felixheld/AXIOM-photonSDI-hw/README.md

AXIOM-photonSDI-hw
===

SDI interface board for the apertus° AXIOM beta camera

* dual high-speed AXIOM connector 
* 2x 6G SDI output on HD-BNC connector
* 1x 6G SDI input on HD-BNC connector
* 1x sync input on HD-BNC connector

Designed with the nightly builds of KiCad version 5. To have all symbols and footprints that are used in the design, you currently need to use the KiCad footprint and symbol repositories on my GitHub account.
