felixheld/AXIOM-photonSDI-hw/AXIOM-photonSDI-hw.pdf

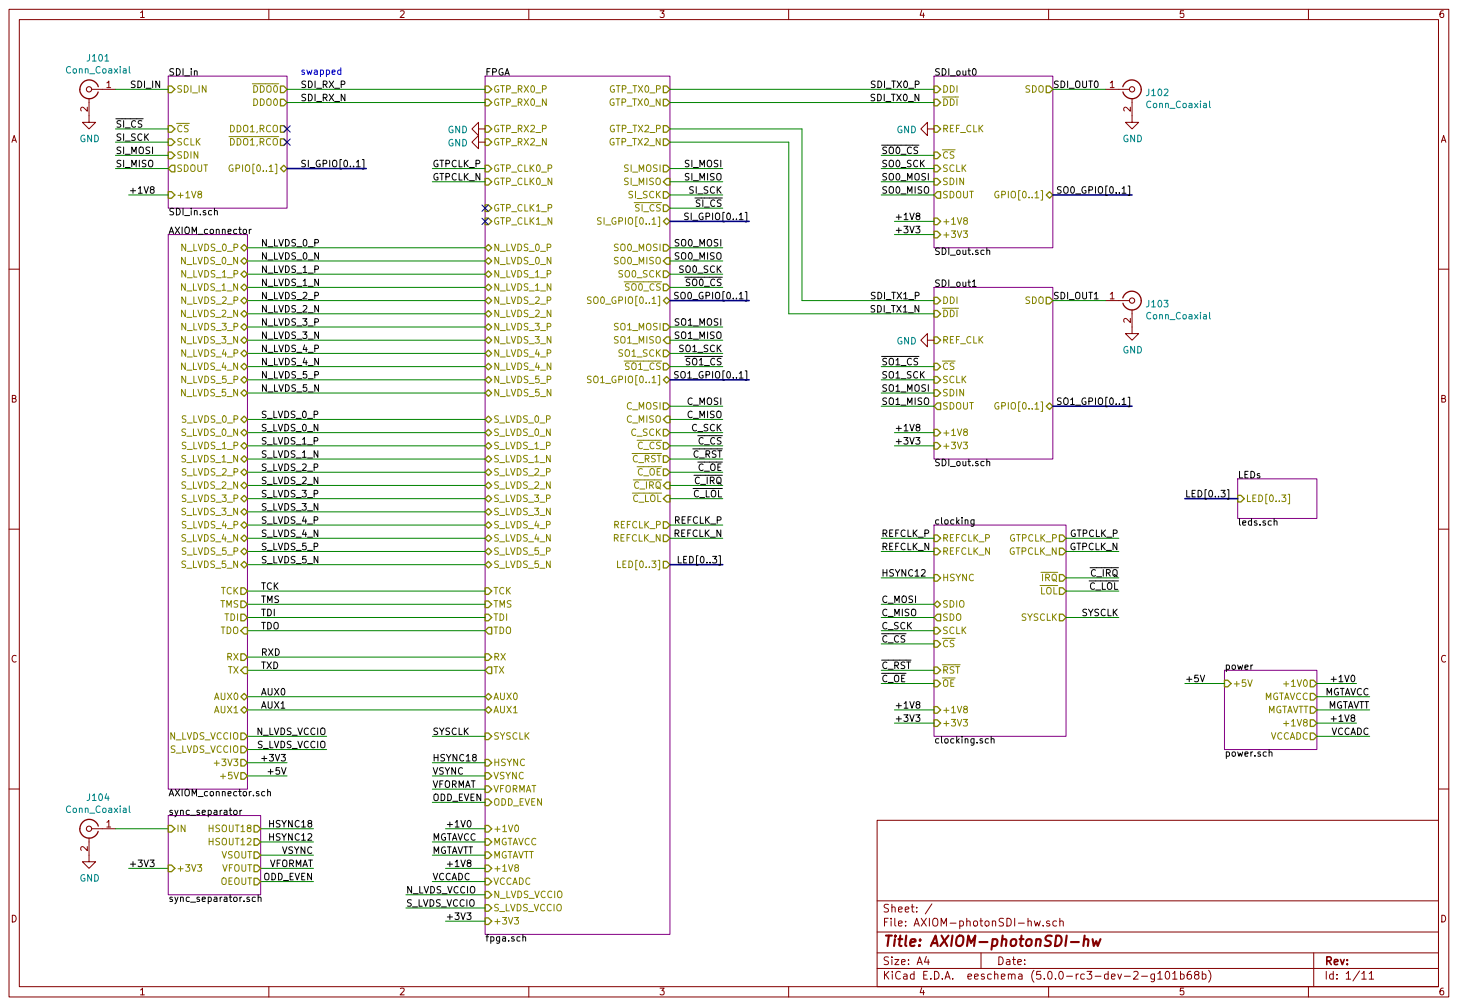
[picture p1: page 1]

SO1_MOSI SO1_MISO | SDI_TX1_N

N_LVDS_3_P N_LVDS_3_N | | SO1_CS

N_LVDS_4_P N_LVDS_4_N | | SO1_SCK

File: AXIOM-photonSDI-hw.sch Sheet: /
Id: 1/11 Title: AXIOM-photonSDI-hw

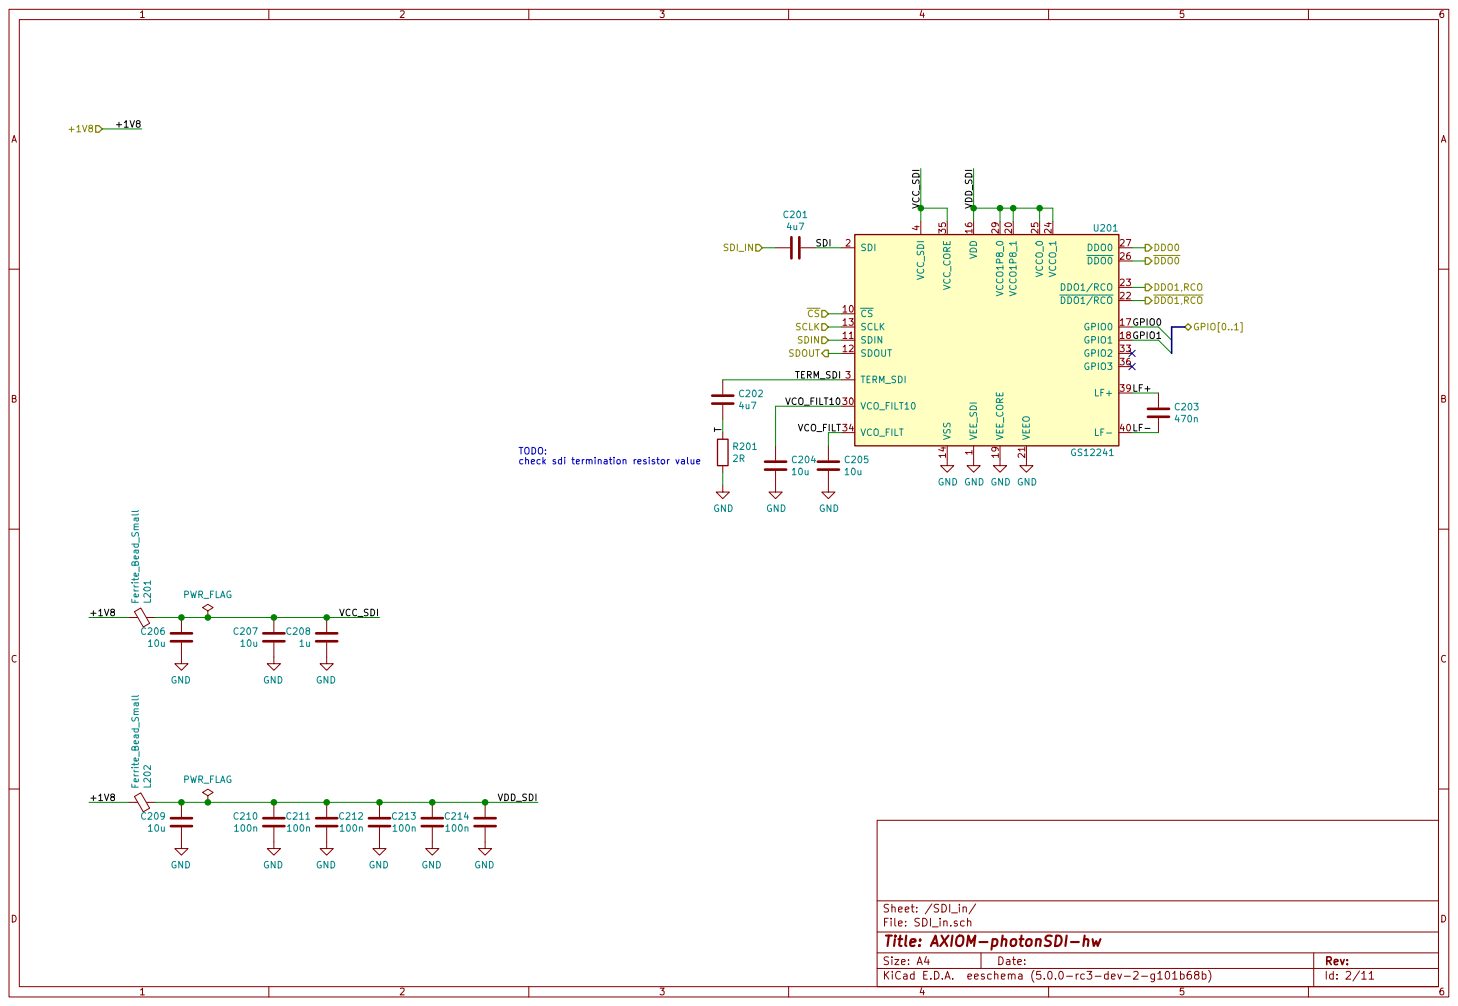
[picture p2: page 2]

470n GND GND GND GND

File: SDI_in.sch
Id: 2/11 Title: AXIOM-photonSDI-hw

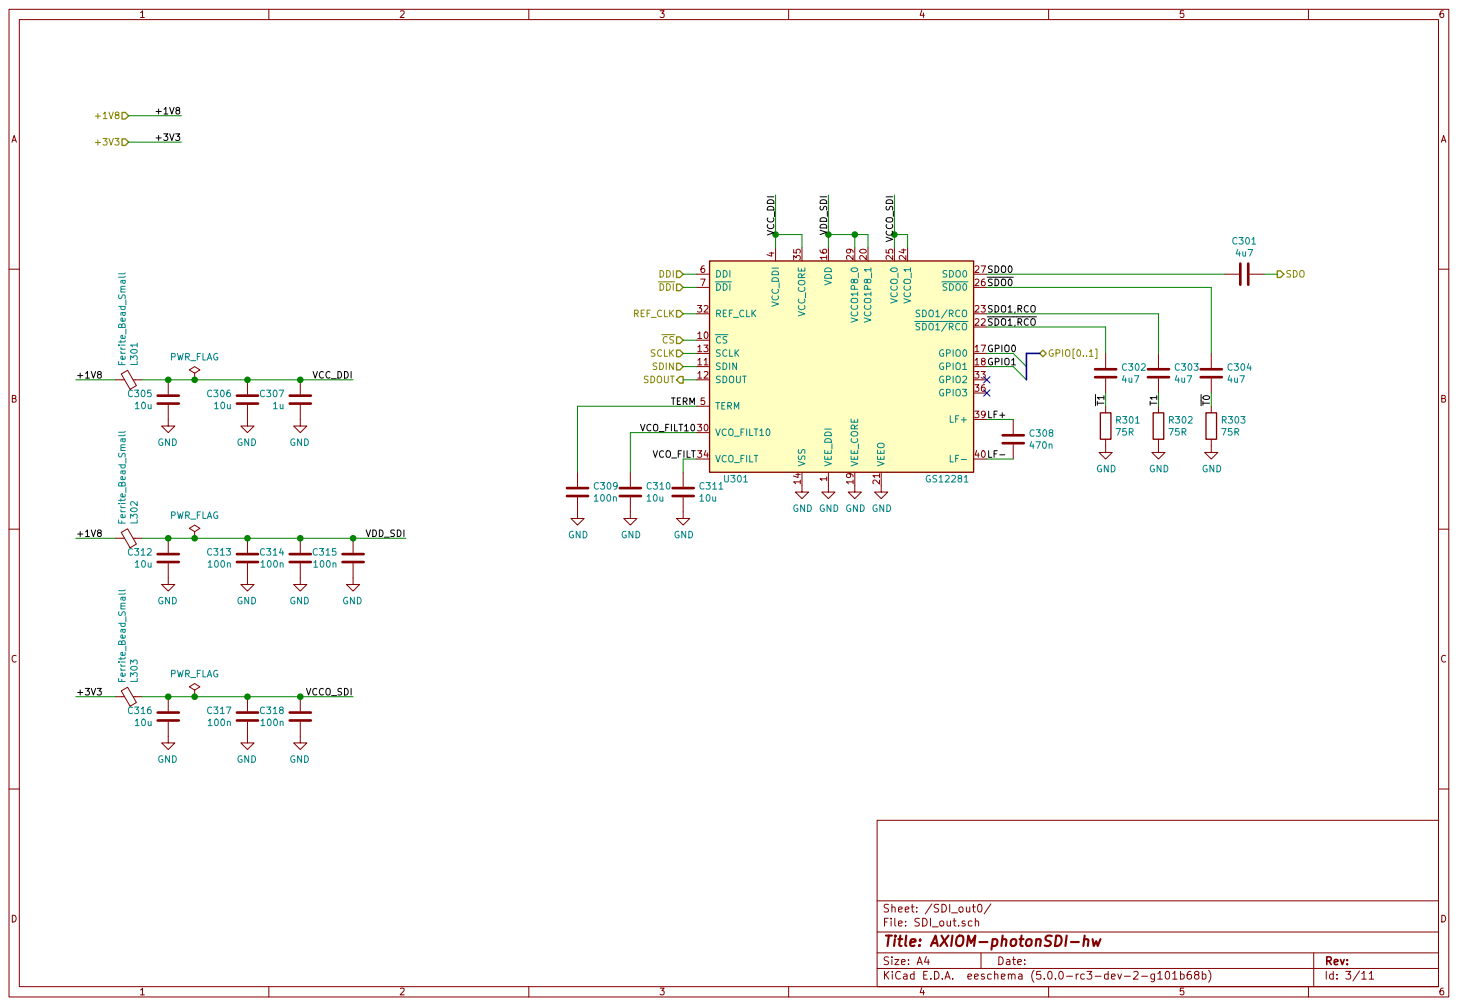
[picture p3: page 3]

470n GND GND GND GND

File: SDI_out.sch
Id: 3/11 Title: AXIOM-photonSDI-hw

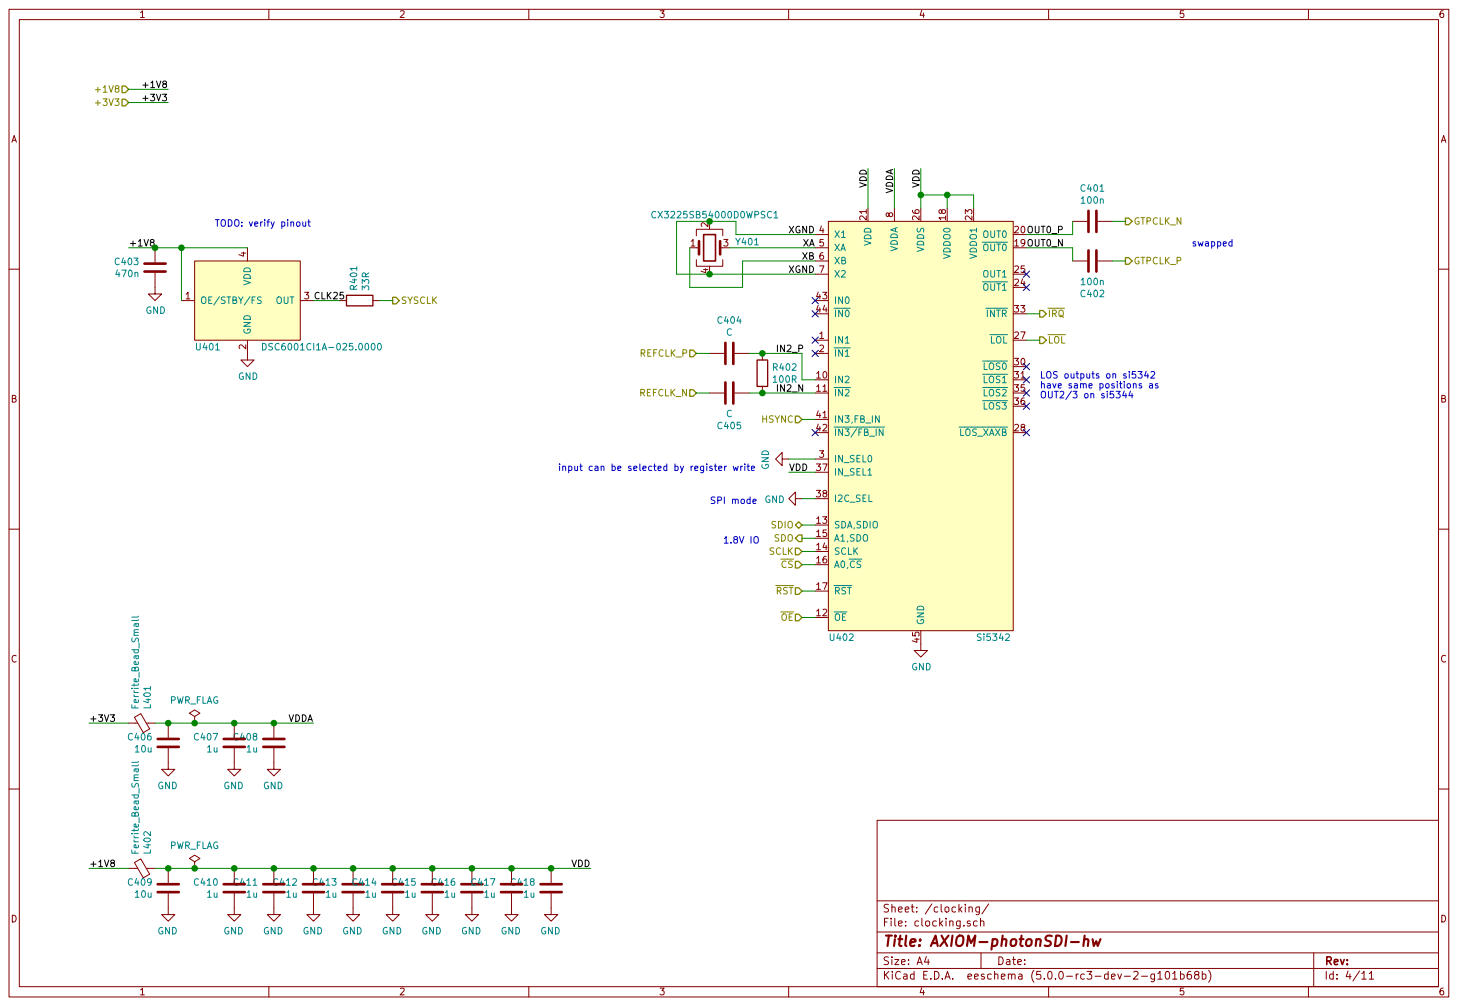
[picture p4: page 4]

Sheet: /clocking/
File: clocking.sch
Id: 4/11 Title: AXIOM-photonSDI-hw

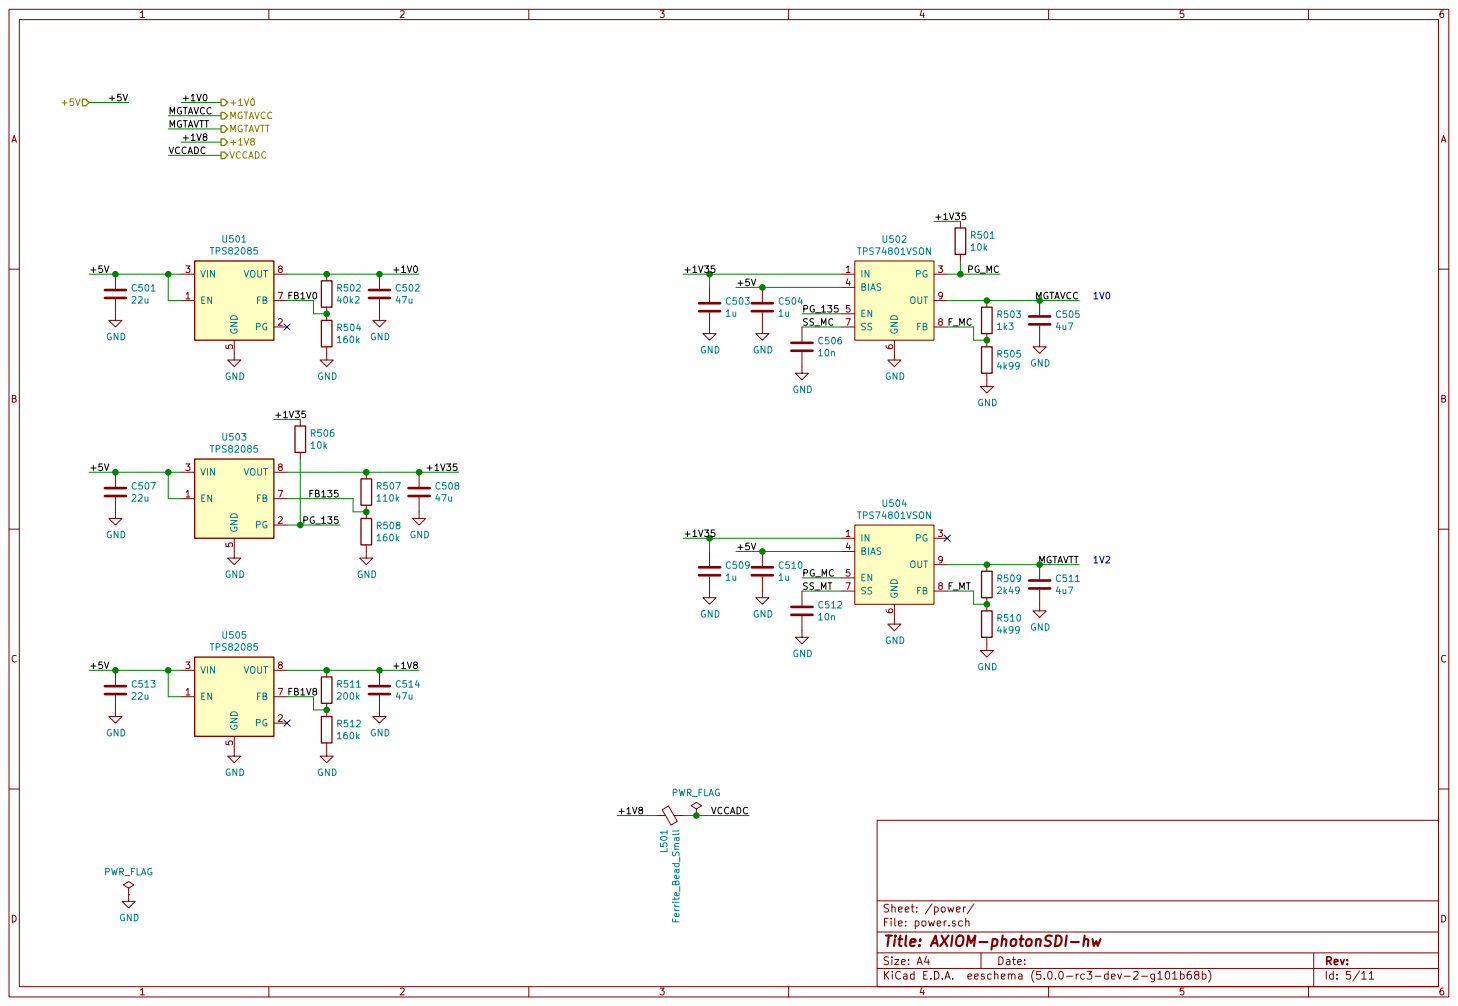
[picture p5: page 5]

Sheet: /power/
File: power.sch
Id: 5/11 Title: AXIOM-photonSDI-hw

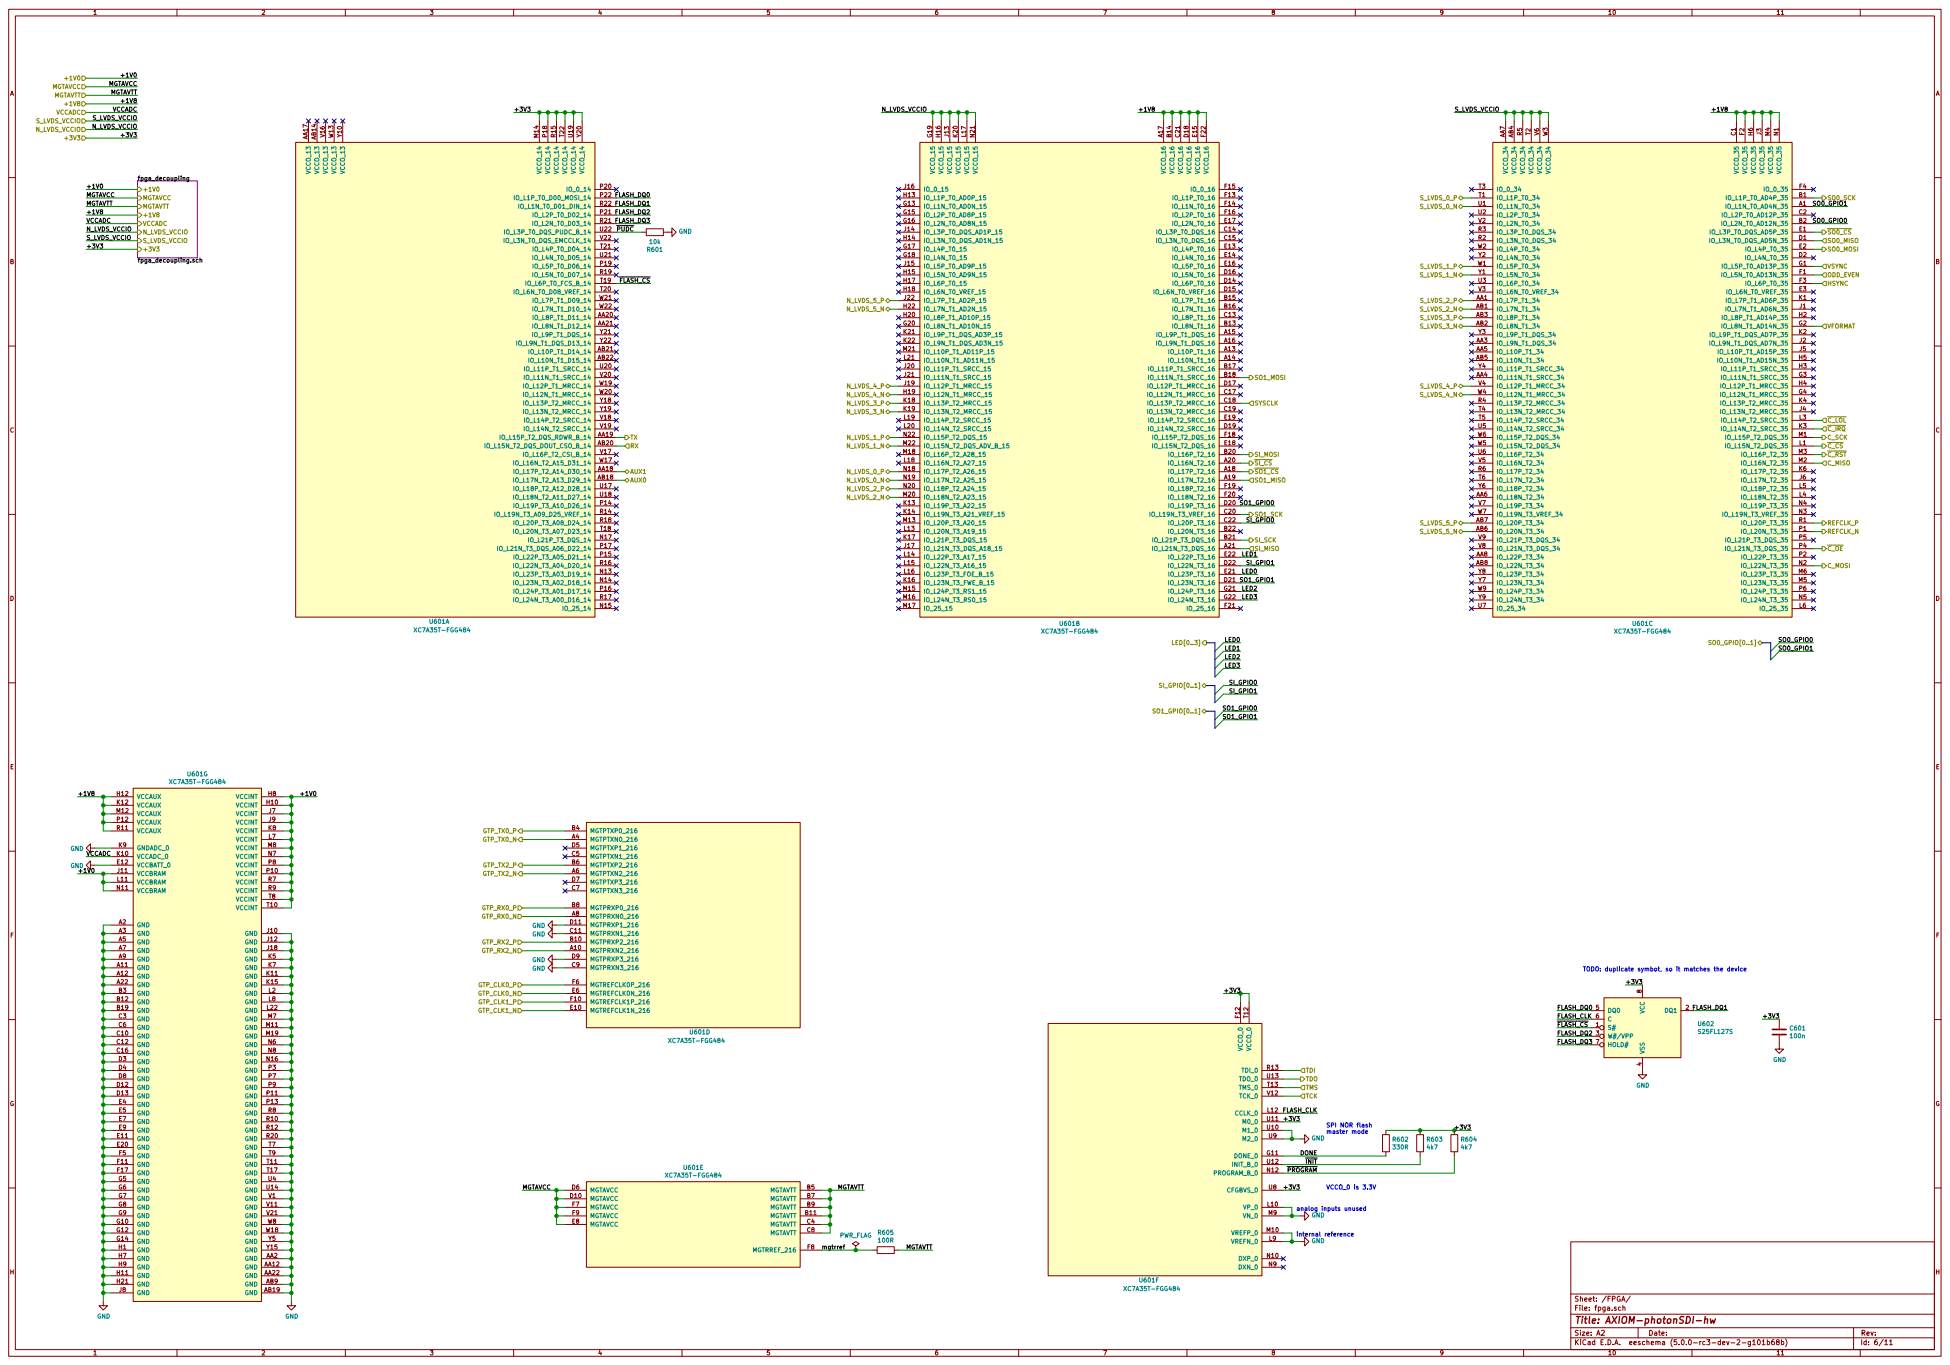
[picture p6: page 6]

fpga_decoupling
fpga_decoupling.sch +3V3 +1V8 +1V0 VCCADC MGTAVCC MGTAVTT S_LVDS_VCCIO

GND GND GND GND GTP_TX0_P GTP_TX0_N GTP_TX2_P GTP_TX2_N GTP_CLK0_P GTP_CLK0_N GTP_CLK1_P GTP_CLK1_N GTP_RX0_P GTP_RX0_N GTP_RX2_P GTP_RX2_N

FLASH_DQ2 FLASH_DQ3 TODO: duplicate symbot, so it matches the device

SPI NOR flash master mode

Id: 6/11 Title: AXIOM-photonSDI-hw

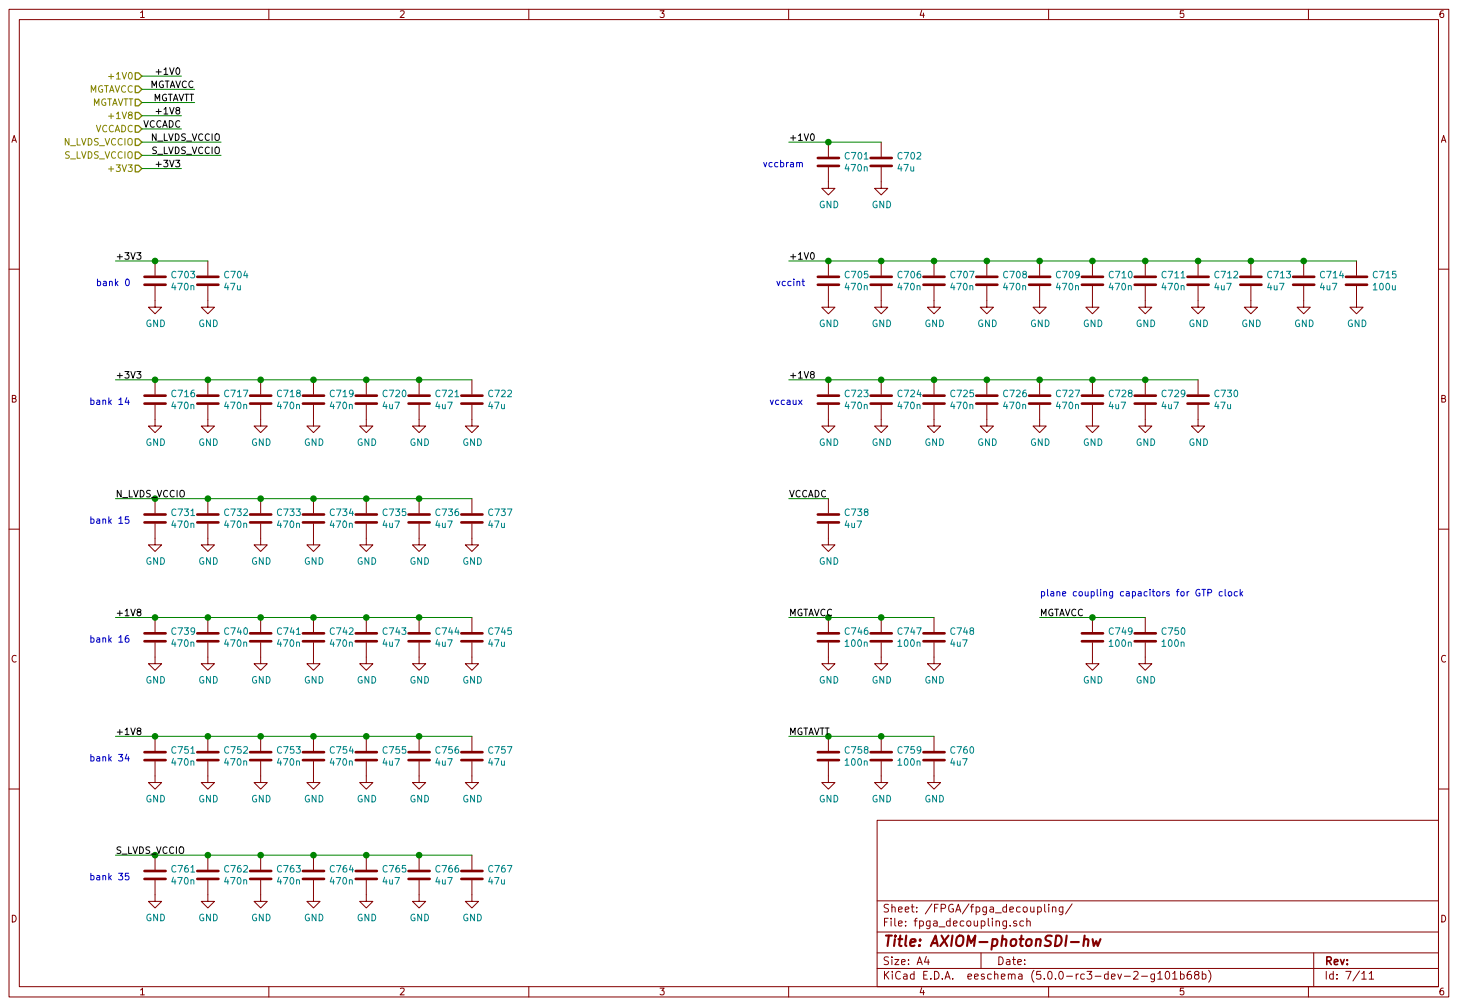
[picture p7: page 7]

plane coupling capacitors for GTP clock

Sheet: /FPGA/fpga_decoupling/
File: fpga_decoupling.sch
Id: 7/11 Title: AXIOM-photonSDI-hw

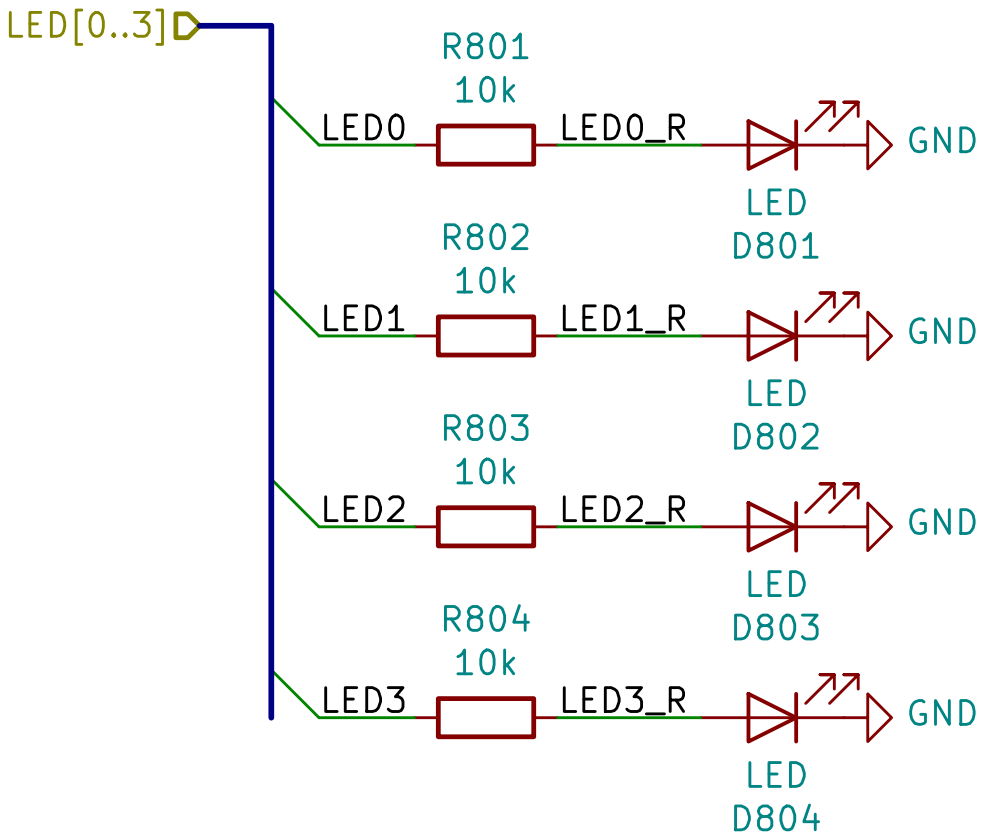
[picture p8: page 8]

LED
File: leds.sch Sheet: /LEDs/ D804

Id: 8/11 Title: AXIOM-photonSDI-hw

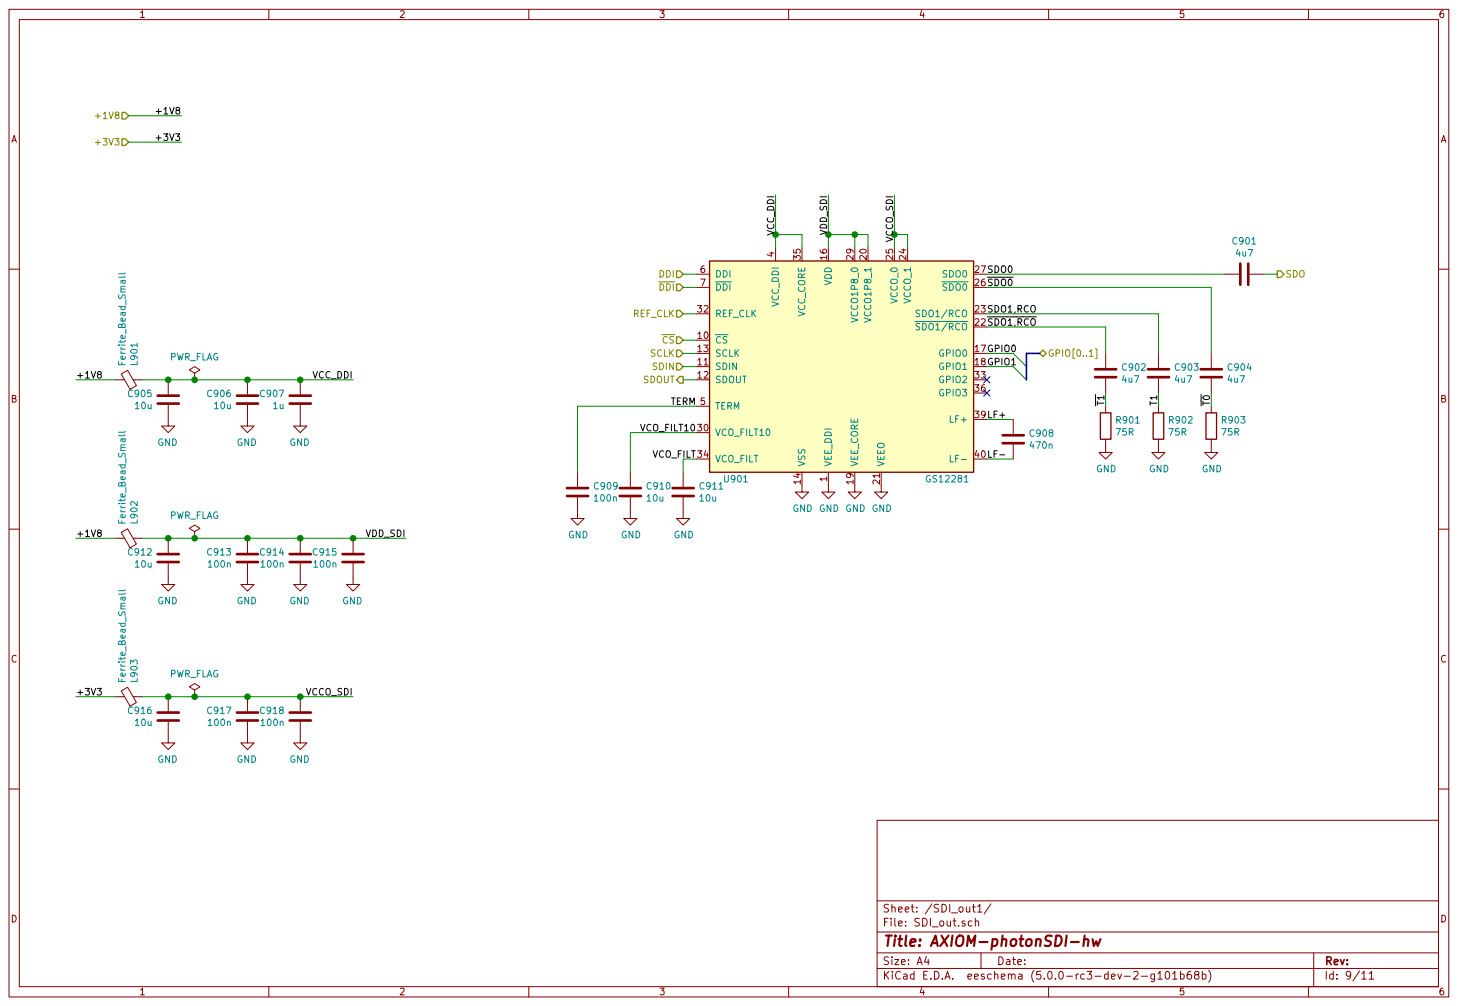
[picture p9: page 9]

470n GND GND GND GND

File: SDI_out.sch
Id: 9/11 Title: AXIOM-photonSDI-hw

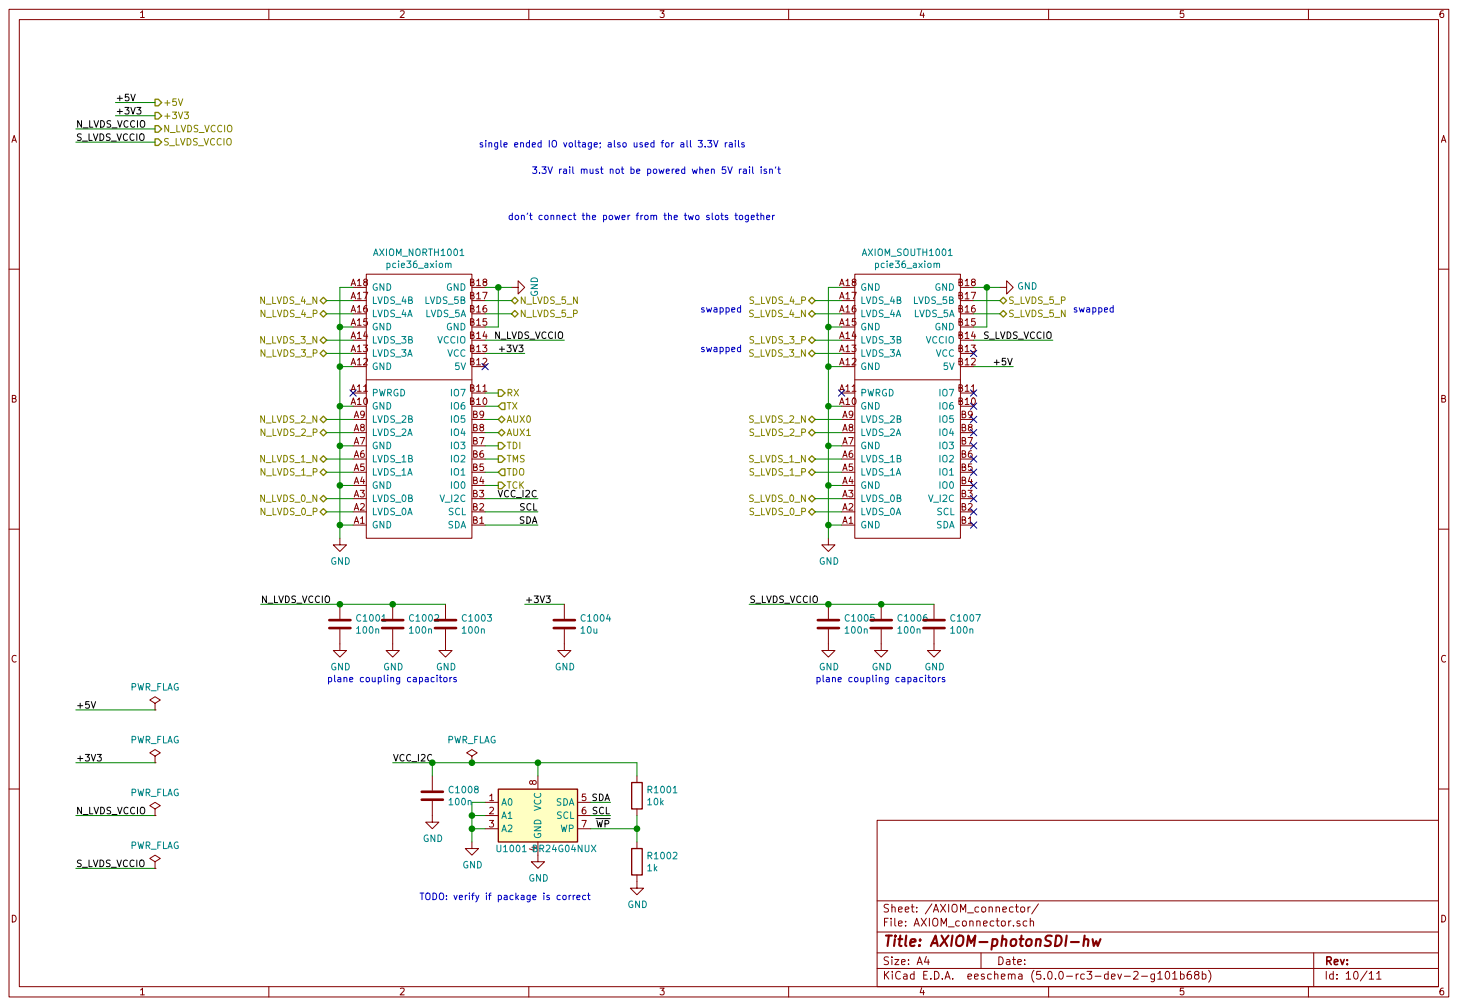
[picture p10: page 10]

don't connect the power from the two slots together R1001

4 SDA 5 SCL 6 WP 7 VCC

TODO: verify if package is correct

File: AXIOM_connector.sch
Id: 10/11 Title: AXIOM-photonSDI-hw

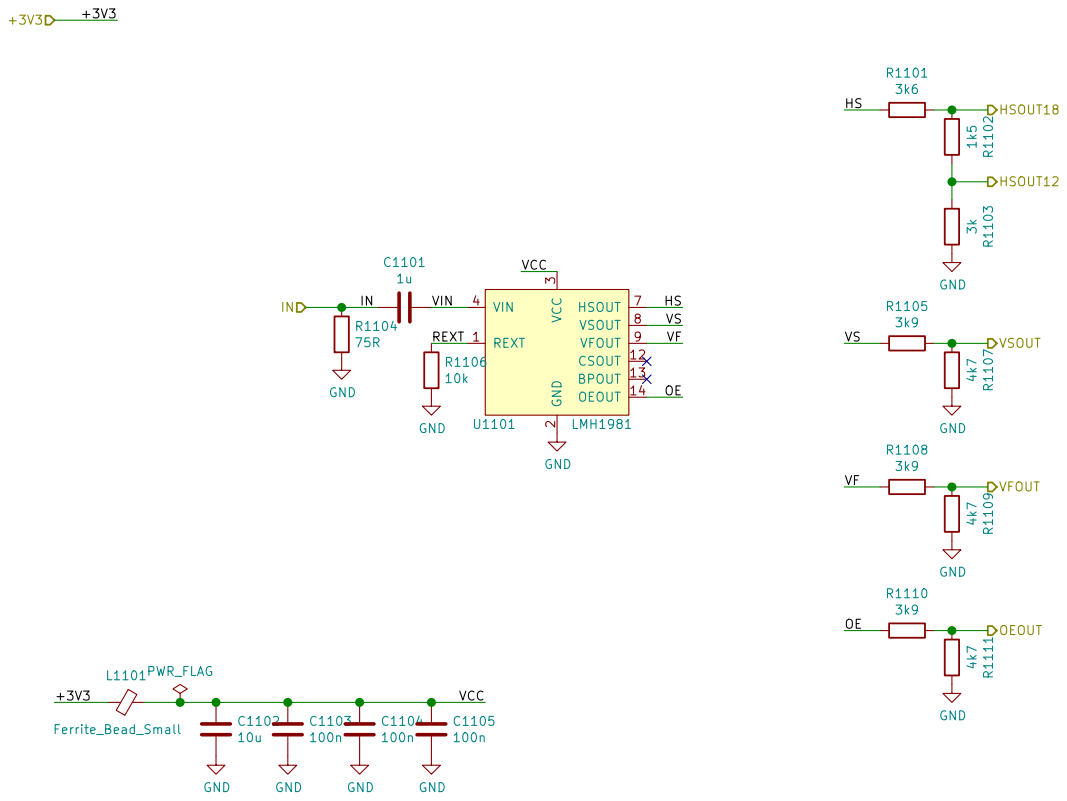
[picture p11: page 11]

3 VIN 4 HSOUT 7 VSOUT 8 VFOUT 9 U1101 LMH1981 GND
