felixheld/AXIOM-photonSDI-hw/(commit log)

2018-07-02 initial schematics and pcb commit
    [AXIOM-photonSDI-hw.kicad_pcb, AXIOM-photonSDI-hw.sch, AXIOM_connector.sch, SDI_in.sch, SDI_out.sch, clocking.sch, fpga.sch, fpga_decoupling.sch]
2018-07-05 mark optional recovered clock output pins of GS12241 as unconnected
    those outputs can't be easily routed to the inputs of the SI5342 chips, so I
    don't support this on the hardware
    [AXIOM-photonSDI-hw.sch]
2018-07-08 fix intra-pair skew
    [AXIOM-photonSDI-hw.kicad_pcb]
2018-07-09 add footprint for crystal on si5342
    [AXIOM-photonSDI-hw.kicad_pcb, clocking.sch]
2018-07-09 route 5V rail and fix polygon priority levels
    [AXIOM-photonSDI-hw.kicad_pcb]
2018-07-09 route GTP reference clock from SI5342
    [AXIOM-photonSDI-hw.kicad_pcb]
2018-07-09 add 25MHz crystal footprint and some small changes in the layout
    [AXIOM-photonSDI-hw.kicad_pcb, clocking.sch]
2018-07-09 fix DRC warnings
    [AXIOM-photonSDI-hw.kicad_pcb]
2018-07-10 remove crystal oscillator from second GTP clock input pair
    The oscillator was intended as a workaround for possible problems with the
    clock from the SI5342, but was rather difficult to fit on the PCB without
    having to compromise on other aspects.
    [AXIOM-photonSDI-hw.kicad_pcb, AXIOM-photonSDI-hw.sch, clocking.sch]
2018-07-14 route +3V3 net and add bypass capacitor
    [AXIOM-photonSDI-hw.kicad_pcb, AXIOM_connector.sch]
2018-07-14 route the 3.3V additionally via another path to lower impedance
    [AXIOM-photonSDI-hw.kicad_pcb]
2018-07-15 route GTP power section and calculate resistor values
    [AXIOM-photonSDI-hw.kicad_pcb, power.sch]
2018-07-15 improve TPS82085 footprint
    [AXIOM-photonSDI-hw.kicad_pcb, power.sch]
2018-07-15 add missing component values
    [AXIOM-photonSDI-hw.kicad_pcb, power.sch, sync_separator.sch]
2018-07-15 slight routing optimizations
    [AXIOM-photonSDI-hw.kicad_pcb]
2018-07-15 fix DRC violations in TPS74801 footprint
    [AXIOM-photonSDI-hw.kicad_pcb]
2018-07-15 fix fiducial problem and component name placement
    [AXIOM-photonSDI-hw.kicad_pcb]
2018-07-15 clean up layout and route passives of SDI chips
    [AXIOM-photonSDI-hw.kicad_pcb]
2018-07-15 route 75 ohm connections
    [AXIOM-photonSDI-hw.kicad_pcb]
2018-07-15 move LVDS lane a bit and fix drc warnings
    the LVDS lane was moved over a plane split
    [AXIOM-photonSDI-hw.kicad_pcb]
2018-07-15 add text on silkscreen
    [AXIOM-photonSDI-hw.kicad_pcb]
2018-07-15 optimize supply rail polygons and set export formats and directory
    [AXIOM-photonSDI-hw.kicad_pcb]
2018-07-15 slightly optimize polygons
    [AXIOM-photonSDI-hw.kicad_pcb]
2018-07-16 slightly round pads of capacitors in critical SDI paths
    [AXIOM-photonSDI-hw.kicad_pcb]
2018-08-09 update capacitor footprints in the critical SDI signal path
    The newer capacitor footprints should have a slightly better RF performance.
    [AXIOM-photonSDI-hw.kicad_pcb]
2018-08-28 fix routing and skew of N_LVDS_4 differential pair
    [AXIOM-photonSDI-hw.kicad_pcb]
2018-08-29 fix paste aperture size of power supply chips
    [AXIOM-photonSDI-hw.kicad_pcb]
2018-09-01 specify part number of crystal on si5342
    [AXIOM-photonSDI-hw.kicad_pcb, clocking.sch]
2018-09-01 remove two unconnected vias on second gtp referece clock input
    this fixes two drc errors
    [AXIOM-photonSDI-hw.kicad_pcb]
2018-09-01 add schematic symbol cache lib
2018-09-01 add a few more vias to ground to the hd-bnc connector's ground pads
    [AXIOM-photonSDI-hw.kicad_pcb]
2018-09-01 add pdf export of schematics
2018-09-01 add archive with generated gerber files to release folder
    This file will only be updated for every release and not for the commits
    inbetween releases.
2018-09-04 add values for differential clock input capacitors
    [clocking.sch]
2018-09-04 fix wrong footprint
    [AXIOM-photonSDI-hw.kicad_pcb, SDI_in.sch]
2018-09-04 specify FPGA speed grade
    [AXIOM-photonSDI-hw.kicad_pcb, fpga.sch]
2018-09-04 specify Si5342 variant
    [AXIOM-photonSDI-hw.kicad_pcb, clocking.sch]
2018-09-05 specify exact part number of flash chip
    [AXIOM-photonSDI-hw.kicad_pcb, fpga.sch]
2018-09-05 change part number of crystal oscillator
    [AXIOM-photonSDI-hw.kicad_pcb, clocking.sch]
2018-09-06 specify voltage rating of capacitors
    [AXIOM-photonSDI-hw.kicad_pcb, AXIOM-photonSDI-hw.sch, power.sch]
2018-09-11 specify current rating of ferrite beads
    [AXIOM-photonSDI-hw.kicad_pcb, SDI_in.sch, SDI_out.sch, clocking.sch, power.sch, sync_separator.sch]
2018-11-16 add interactive BOM
    generated with https://github.com/openscopeproject/InteractiveHtmlBom
2018-12-29 break loop in 3.3V net
    [AXIOM-photonSDI-hw.kicad_pcb]
2018-12-30 update some passives to new footprints
    maybe half of the conversion is done now. some DRC problems were fixed as well
    [AXIOM-photonSDI-hw.kicad_pcb]
2018-12-31 move eeprom to south conector
    also move the 5v->1,8v stepdown a bit to have space for the eeprom
    [AXIOM-photonSDI-hw.kicad_pcb, AXIOM-photonSDI-hw.sch, AXIOM_connector.sch, SDI_in.sch, SDI_out.sch, clocking.sch, fpga.sch, fpga_decoupling.sch]
2018-12-31 remove unnecessary 5v island on plane 3
    [AXIOM-photonSDI-hw.kicad_pcb]
2018-12-31 rework plane coupling capacitors on axiom connector
    [AXIOM-photonSDI-hw.kicad_pcb, AXIOM_connector.sch]
2018-12-31 convert more passives to the new footprints
    [AXIOM-photonSDI-hw.kicad_pcb]
2018-12-31 add missing ground plane cutout below the coupling capacitors of gtp refclk
    [AXIOM-photonSDI-hw.kicad_pcb]
2019-01-17 improve routing of gtp reference clock
    [AXIOM-photonSDI-hw.kicad_pcb]
2019-01-17 fix drc errors
    [AXIOM-photonSDI-hw.kicad_pcb]
2019-01-17 update the rest of the passives footprints on the top side
    [AXIOM-photonSDI-hw.kicad_pcb]
2019-01-17 update all passives footprints except the bypass capacitirs of the clock generator
    [AXIOM-photonSDI-hw.kicad_pcb]
2019-01-17 update the remaining passives' footprints
    [AXIOM-photonSDI-hw.kicad_pcb]
2019-01-17 connect the non-fpga pin of the leds to vcc insted of gnd
    [AXIOM-photonSDI-hw.kicad_pcb, AXIOM-photonSDI-hw.sch, leds.sch]
2019-01-18 connect leds to 3v3 power supply rail
    the led is still connected to a 1v8 fpga io bank though
    [AXIOM-photonSDI-hw.kicad_pcb, AXIOM-photonSDI-hw.sch, fpga.sch, leds.sch]
2019-01-18 fix moved plane bug, add init, done and power enable signals and optimize design
    [AXIOM-photonSDI-hw.kicad_pcb, AXIOM-photonSDI-hw.sch, AXIOM_connector.sch, fpga.sch, power.sch]
2019-01-18 add capacitor type labels and pin 1 marks
    [AXIOM-photonSDI-hw.kicad_pcb]
2019-01-19 add 3 resistor footprints to configure a board ID to be able to detect revision and features present
    [AXIOM-photonSDI-hw.kicad_pcb, fpga.sch]
