felixheld/AXIOM-photonSDI-hw/(notices)

Notices in the files:
AXIOM-photonSDI-hw.kicad_pcb:
(c) 2018 Felix Held
CC-BY-SA-4.0
